pep3175/Retro-PixelBoy/README.md

# Retro-PixelBoy
Retropie handheld gaming console based on CM3+
