pep3175/Retro-PixelBoy/Hardware/BOM_RetroBoy_2020-05-26_08-28-46.xlsx

ID | Name | Designator | Footprint | Quantity | Manufacturer Part | Manufacturer | Supplier | Supplier Part | LCSC Assembly
1 | MAX98357A | U9 | QFN16_3MM | 1
2 | 10K | R14,R15,R16,R17,R18,R19,R29 | R0805 | 7 | PTFR0805B10K0N9 | ResistorToday | LCSC | C328436
3 | 10uF | C24,C22,C13 | CAP-SMD_L3.2-W1.6-R-RD | 3 | CA45A-A-10V-10uF-M | Shenzhen Zhenhua XinYun Elec | LCSC | C141307 | Yes
4 | BAT54C | D2 | SOT-23-3_L2.9-W1.3-P1.90-LS2.4-BR | 1 | BAT54C | Hottech | LCSC | C181200 | Yes
5 | microUSB | USB1 | MICRO-USB-SMD_5P-P0.65-H-F_MICRO5.9MMUSB | 1 | MICRO5.9mmusb | SHOU HAN | LCSC | C393940
6 | 100nF | C12,C14,C21,C6,C5,C4,C26 | C0805 | 7 | CC0805KRX7R9BB104 | YAGEO | LCSC | C49678 | Yes
7 | 600Ω | L4,L3 | L0805 | 2 | MMZ2012S601AT000 | TDK | LCSC | C15014 | Yes
8 | SP6205 | U2 | SOT-23-5_L3.0-W1.7-P0.95-LS2.8-BL | 1 | SP6205EM5-L-3.3/TR | EXAR | LCSC | C13480 | Yes
9 | 2 | R3,R22 | R0805 | 2 | RCT052RFLF | Hong Kong Resistors | LCSC | C178168
10 | L | KEY1 | GBA SP SHOULDER TRIGGER | 1
11 | R | KEY2 | GBA SP SHOULDER TRIGGER | 1
12 | PT4103 | U6 | SOT-23-6_L2.9-W1.6-P0.95-LS2.8-BL | 1 | PT4103B23F | PowTech | LCSC | C19861 | Yes
13 | 10uF | C19,C18,C17,C16,C25 | C0805 | 5 | 0805X106K6R3 | Huaxin S&T | LCSC | C123652
14 | IP5306 | U4 | ESOP-8_L4.9-W3.9-P1.27-LS6.0-BL-EP | 1 | IP5306 | INJOINIC | LCSC | C181692 | Yes
15 | 17-21/GHC-YR1S2/3T | LED1 | LED0805-R-RD | 1 | 17-21/GHC-YR1S2/3T | EVERLIGHT | LCSC | C73546 | Yes
16 | 100uF | C23 | CAP-SMD_L3.5-W2.8 | 1 | CA45-B-6.3V-100uF-M | Shenzhen Zhenhua XinYun Elec | LCSC | C140373 | Yes
17 | 5.23 | R37 | R0805 | 1 | 0805W8F523KT5E | Uniroyal Elec | LCSC | C422724
18 | 1N5819 | D3 | SOD-123F_L2.8-W1.8-LS3.7-RD | 1 | 1N5819HW1-7-F | DIODES | LCSC | C117948 | Yes
19 | AMS1117-1.8 | U7 | SOT-223-4_L6.5-W3.5-P2.30-LS7.0-BR | 1 | AMS1117-1.8 | AMS | LCSC | C6185 | Yes
20 | microSD | CARD3 | SD-SMD_DM3AT-SF-PEJM5 | 1 | DM3AT-SF-PEJM5 | Hirose | LCSC | C114218
21 | select | SW7 | KEY-SMD_4P-L4.0-W4.8-P3.90-LS4.8 | 1 | SKRBAAE010 | ALPS | LCSC | C115356
22 | start | SW8 | KEY-SMD_4P-L4.0-W4.8-P3.90-LS4.8 | 1 | SKRBAAE010 | ALPS | LCSC | C115356
23 | PWR | SW10 | KEY-SMD_4P-SKSCLXX010 | 1 | SKSCLBE010 | ALPS | LCSC | C115361
24 | AMS1117-3.3 | U1 | SOT-223-3_L6.5-W3.4-P2.30-LS7.0-BR | 1 | AMS1117-3.3 | AMS | LCSC | C6186 | Yes
25 | 200K | R27 | R0805 | 1 | RT0805FRD07200KL | YAGEO | LCSC | C136906
26 | ATTINY85 | U3 | SOIC-8_L5.3-W5.3-P1.27-LS8.0-BL | 1 |  |  | LCSC | C89852
27 | 220pF | C28,C27 | C0805 | 2 | GCJ219R72A221KA01D | Murata Electronics | LCSC | C354373
28 | 17-21SURC/S530-A2/TR8 | LED2 | LED0805-RD | 1 | 17-21SURC/S530-A2/TR8 | EVERLIGHT | LCSC | C131244 | Yes
29 | 22uH | L1 | IND-SMD_L3.0-W3.0 | 1 | CKCS3015-22uH/M | CENKER | LCSC | C354567
30 | 4.7uF | C1 | C0805 | 1 | JMK212BJ475KG-T | TAIYO YUDEN | LCSC | C92788
31 | 17-215/S2C-BJ1K2AX/3T | LED3 | LED0805-R-RD | 1 | 17-215/S2C-BJ1K2AX/3T | EVERLIGHT | LCSC | C95814
32 | 1uF | C2,C11,C3 | C0805 | 3 | C0805X105K101TDF | Holy Stone Enterprise | LCSC | C337981
33 | 1K | R1,R4,R11,R12 | R0805 | 4 | TC0525F1001T5E | UniOhm | LCSC | C75781 | Yes
34 | 2501R-2P | BAT | CONN-TH_2501R-2P | 1 | 2501R-2P | Ckmtw | LCSC | C132479
35 | S8050 | Q1,Q2,Q3 | SOT-23-3_L3.0-W1.7-P0.95-LS2.9-BR | 3 | S8050 | LGE | LCSC | C402279
36 | 1473005-4 | CN1 | SO-DIMM-SMD_200P-P0.60_1473005-4 | 1 | 1473005-4 | TE Connectivity | LCSC | C428482
37 | 22uF | C7,C8,C15,C10,C9 | C1210 | 5 | GRM32ER61E226KE15L | MuRata | LCSC | C65428
38 | 1M | R10,R30 | R0805 | 2 | RK73B2ATTD105J | KOA Speer Elec | LCSC | C316827
39 | SI2305 | Q4,Q5 | SOT-23-3_L2.9-W1.3-P1.90-LS2.4-BR | 2 | SI2305 | Hottech | LCSC | C181088 | Yes
40 | 100K | R5,R6,R7,R8,R9,R2,R20,R21,R24,R25 | R0805 | 10 | RC0805FR-07100KL | YAGEO | LCSC | C96346
41 | 1uH | L2 | IND-SMD_L7.1-W6.6 | 1 | SMMS0650-1R0M | SXN | LCSC | C149578
42 | Y | SW2 | KEY-SMD_4P-L7.5-W7.0-P6.00-LS5.0 | 1 | SKRRABE010 | ALPS | LCSC | C125046
43 | B | SW3 | KEY-SMD_4P-L7.5-W7.0-P6.00-LS5.0 | 1 | SKRRABE010 | ALPS | LCSC | C125046
44 | X | SW4 | KEY-SMD_4P-L7.5-W7.0-P6.00-LS5.0 | 1 | SKRRABE010 | ALPS | LCSC | C125046
45 | A | SW5 | KEY-SMD_4P-L7.5-W7.0-P6.00-LS5.0 | 1 | SKRRABE010 | ALPS | LCSC | C125046
46 | LCD | FPC1 | FPC-SMD_P0.50-54P_LCS-SJ-H2.0 | 1 | AFC07-S54ECC-00 | JUSHUO | LCSC | C262258
47 | dPad | SW6 | SW-SMD_SKRHAAE010 | 1 | SKRHAAE010 | ALPS Electric | LCSC | C202423
