pep3175/Retro-PixelBoy/3D printing/ActionButton v2.stl

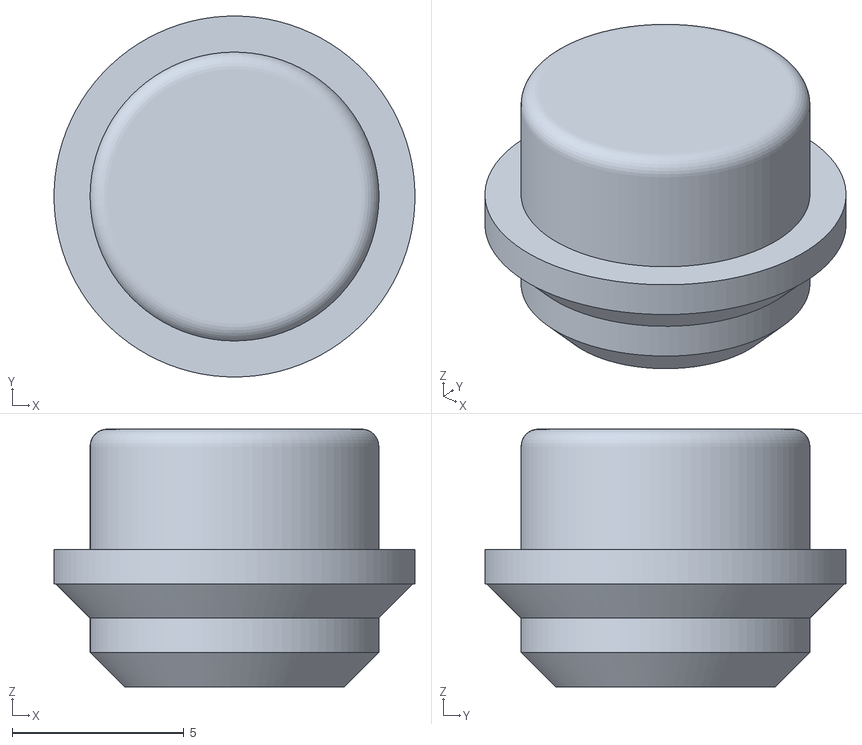
[picture p1: CAD file, 2020-06-24]
3D printing/ActionButton v2.stl
10.5 x 10.5 x 7.50
