pep3175/Retro-PixelBoy/3D printing/D-Pad_test v0.stl

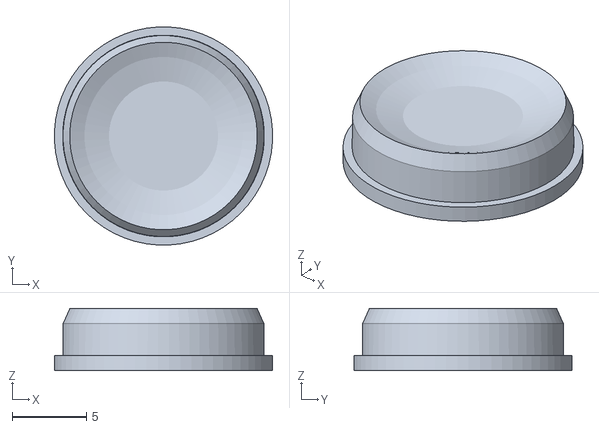
[picture p2: CAD file, 2020-06-24]
3D printing/D-Pad_test v0.stl
14.7 x 14.7 x 4.18
