pep3175/Retro-PixelBoy/3D printing/Button_start-select v1.stl

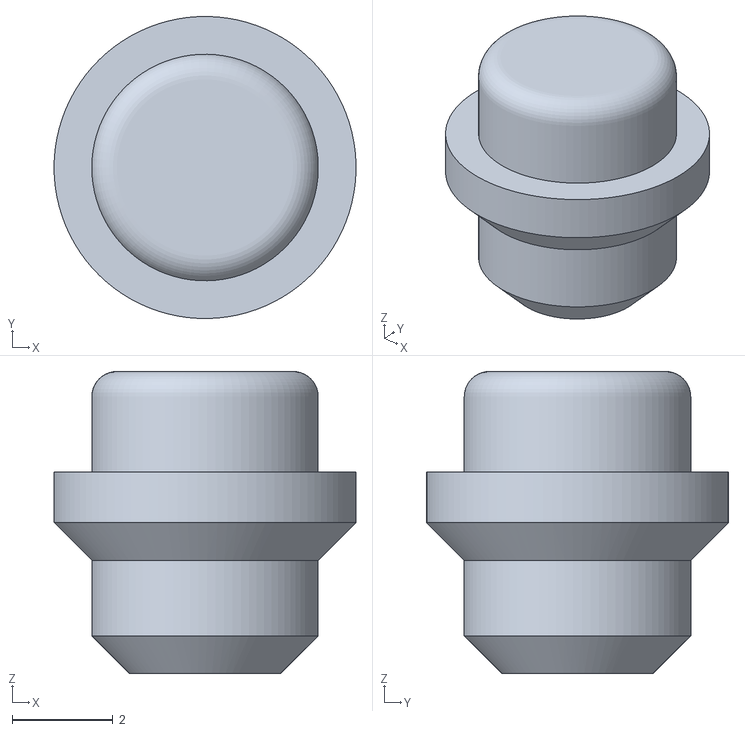
[picture p3: CAD file, 2020-06-24]
3D printing/Button_start-select v1.stl
6.00 x 6.00 x 6.00
