pep3175/Retro-PixelBoy/3D printing/Shoulder R.stl

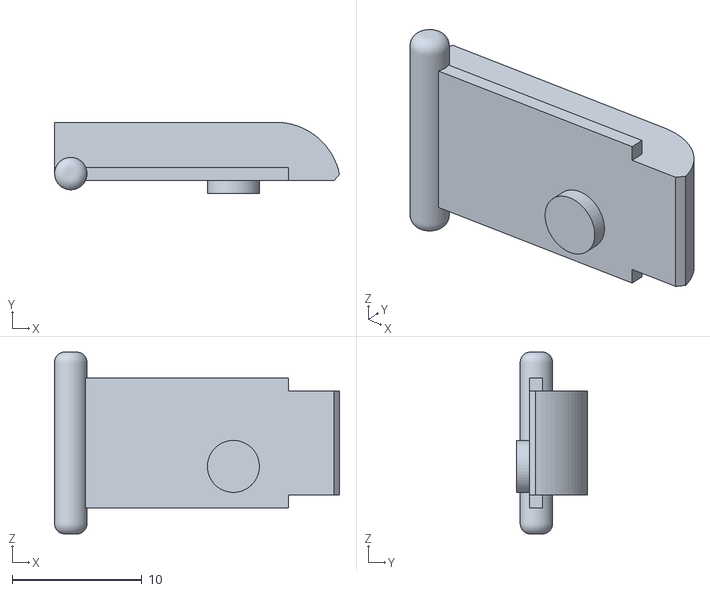
[picture p4: CAD file, 2020-06-24]
3D printing/Shoulder R.stl
21.9 x 5.50 x 14.0
