pep3175/Retro-PixelBoy/3D printing/Top.stl

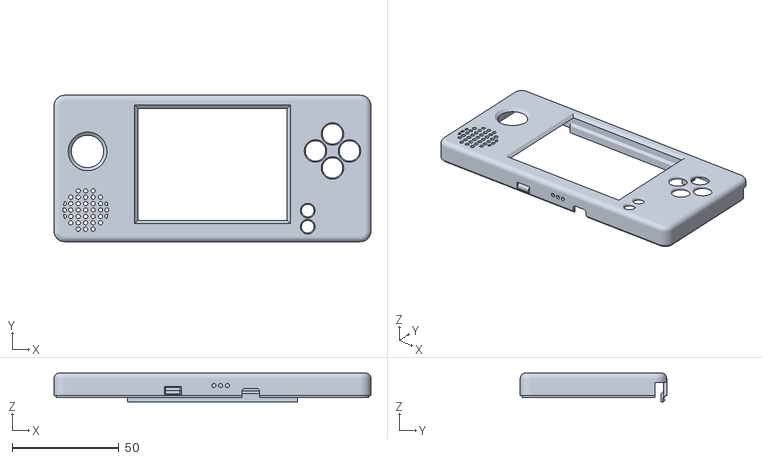
[picture p5: CAD file, 2020-06-24]
3D printing/Top.stl
148.8 x 68.8 x 13.6
