pep3175/Retro-PixelBoy/3D printing/Bottom.stl

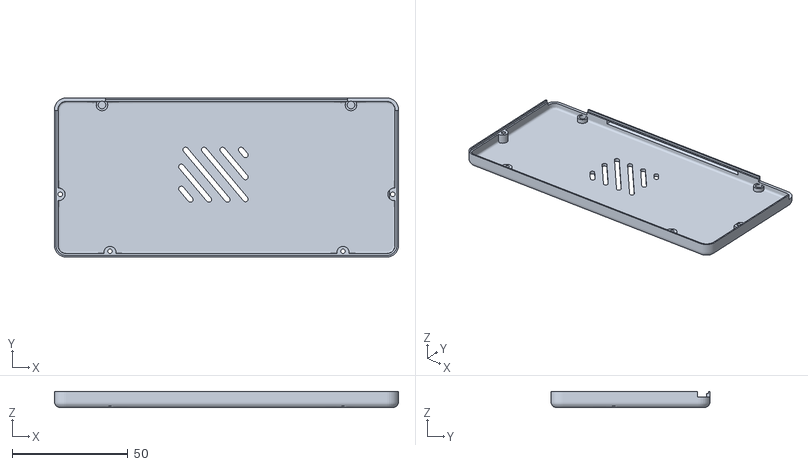
[picture p6: CAD file, 2020-06-24]
3D printing/Bottom.stl
148.8 x 68.8 x 7.00
