pep3175/Retro-PixelBoy/(list of files, cad)

Other CAD files:
3D printing/button_dpad v1.stl
3D printing/Shoulder L.stl
