pep3175/Retro-PixelBoy/Hardware/Schematic_RetroBoy_2020-06-16_17-44-25.pdf

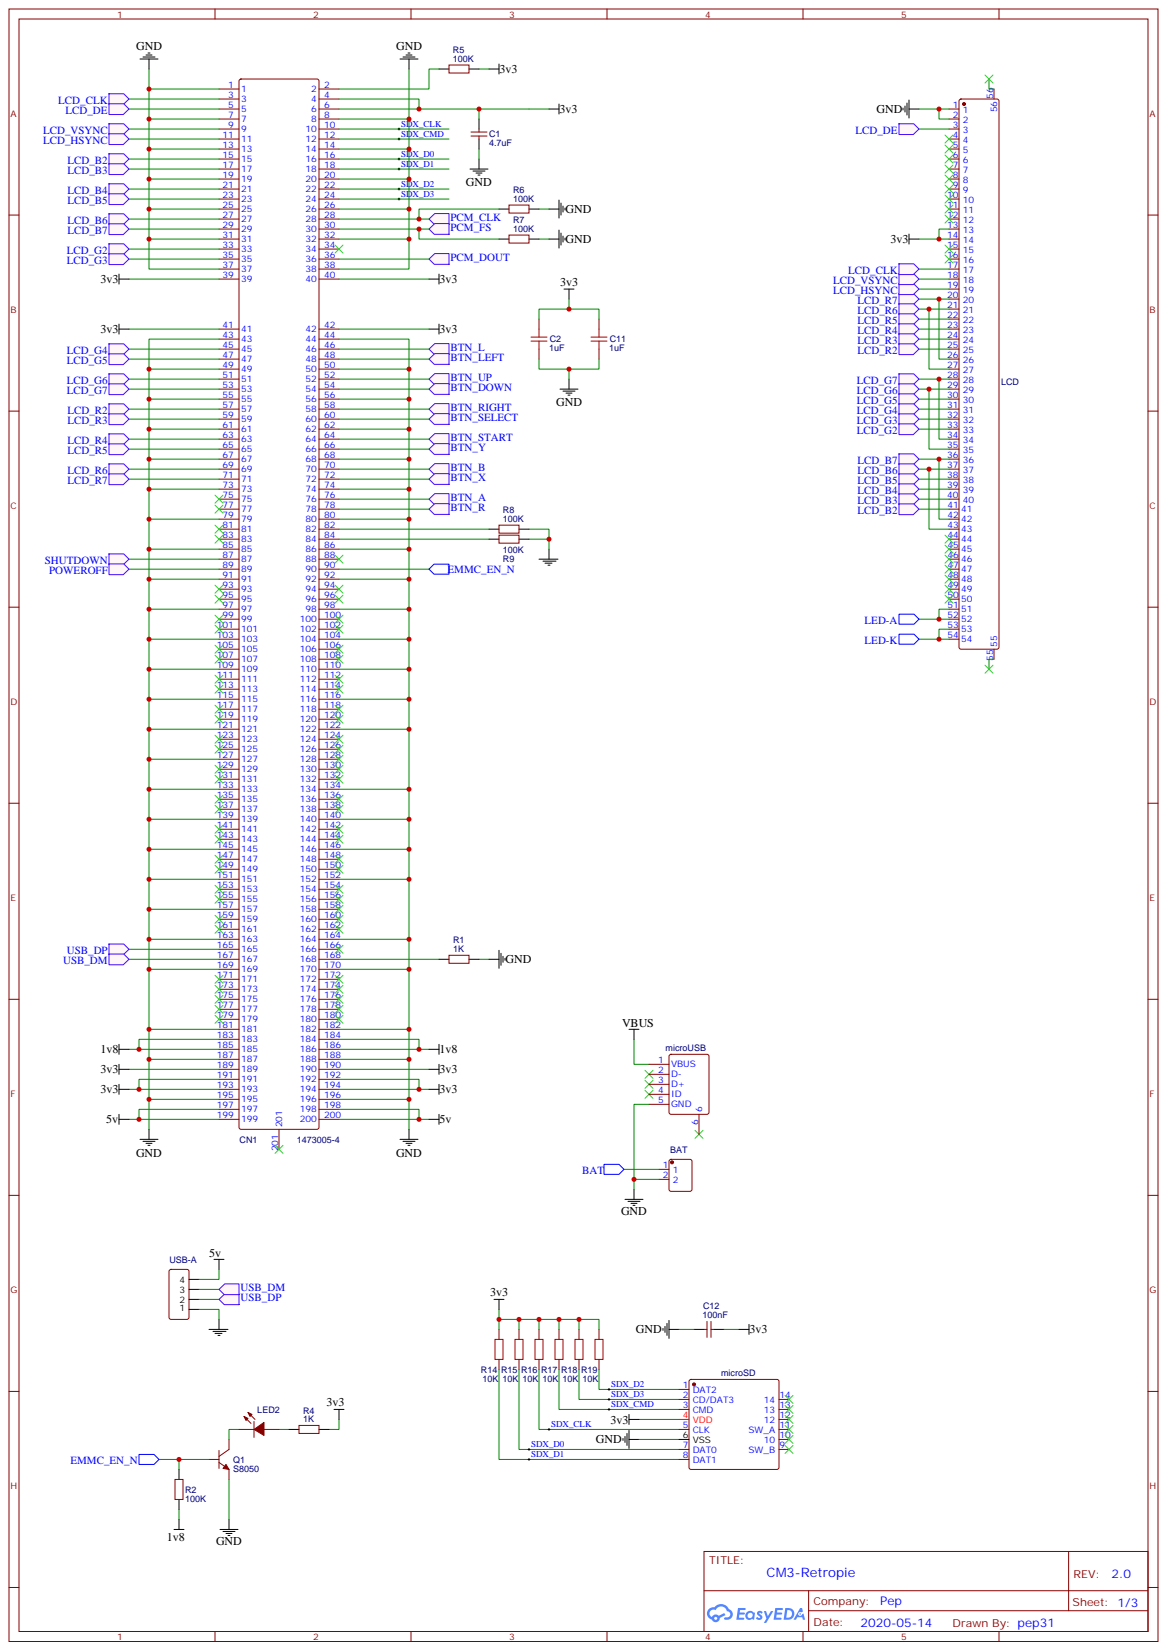
[picture p7: page 1]

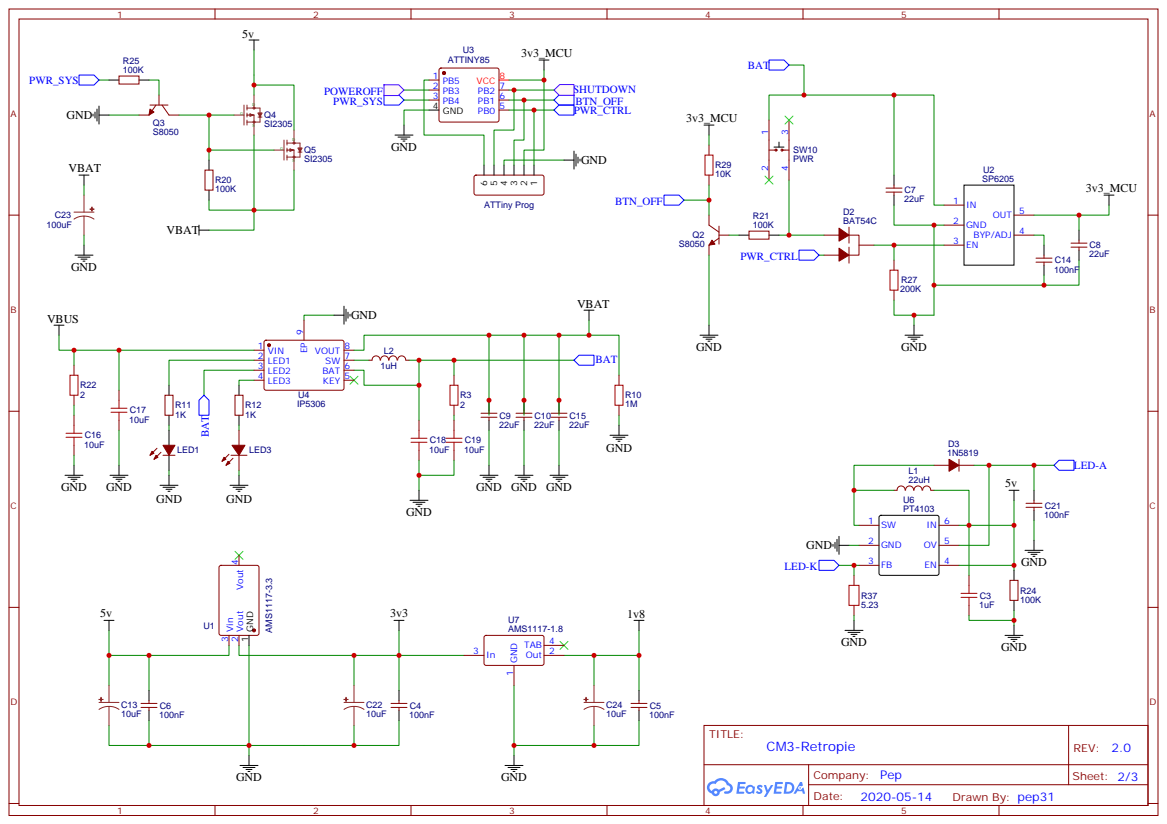
[picture p8: page 2]

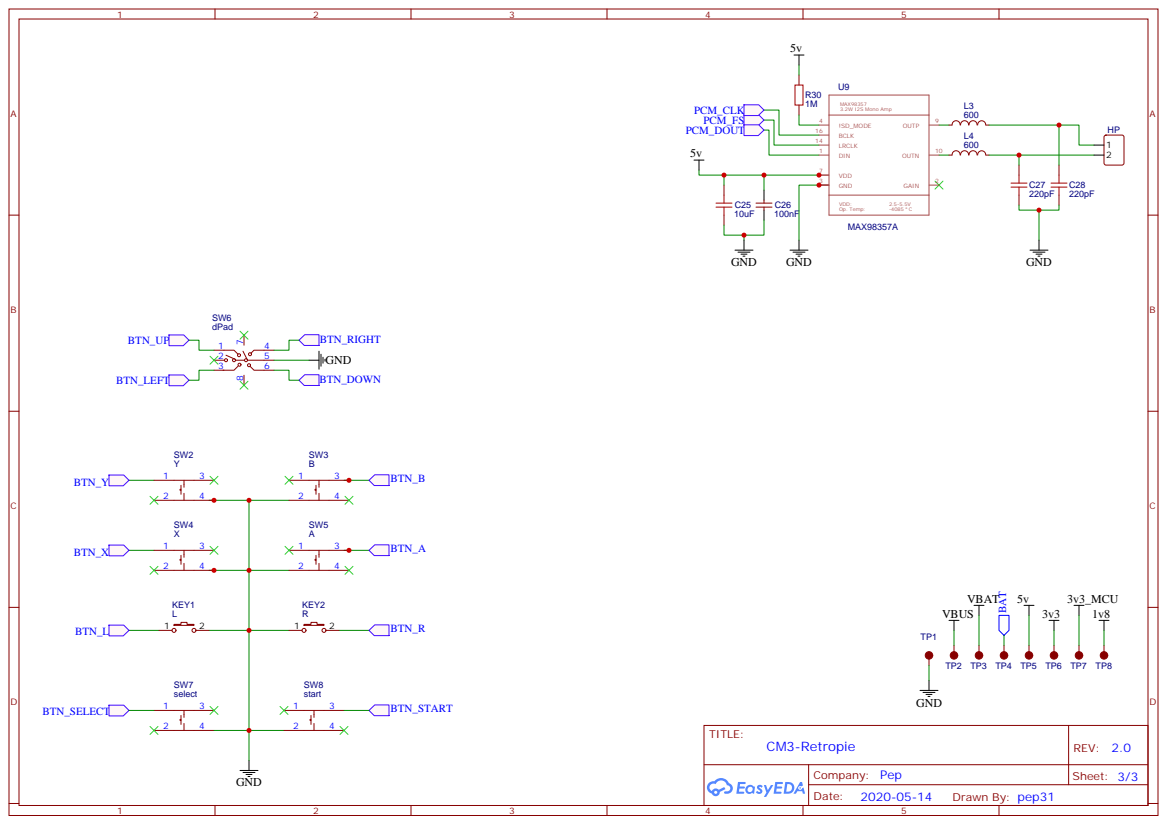
[picture p9: page 3]
